lu-lab/mi-pi/docs/assembly images/IMG_20190503_181630.jpg

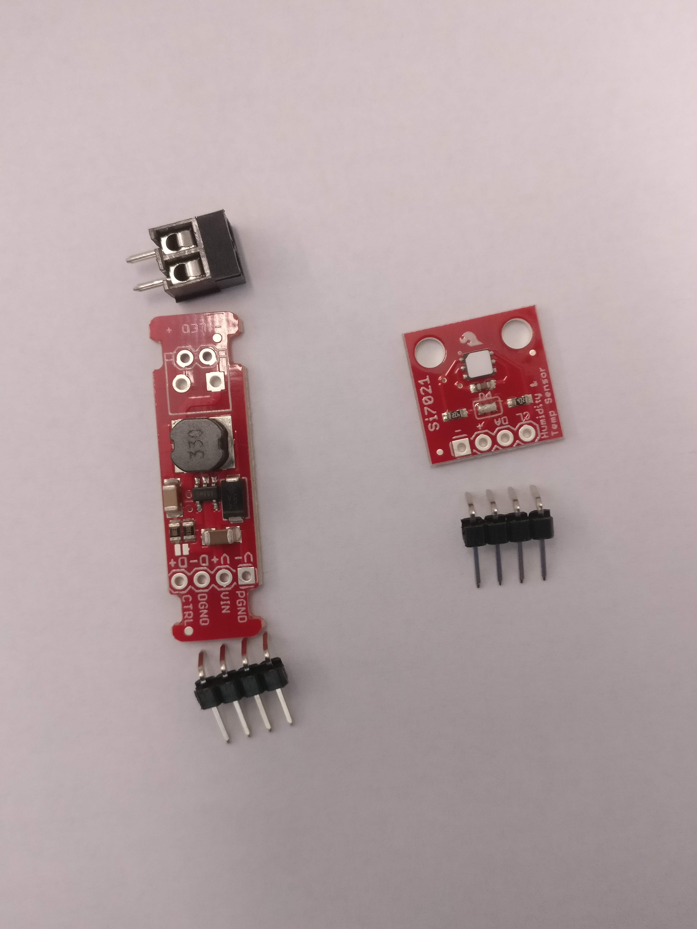
docs/assembly images/IMG_20190503_181630.jpg
