lu-lab/mi-pi/docs/assembly images/IMG_20190503_181736.jpg

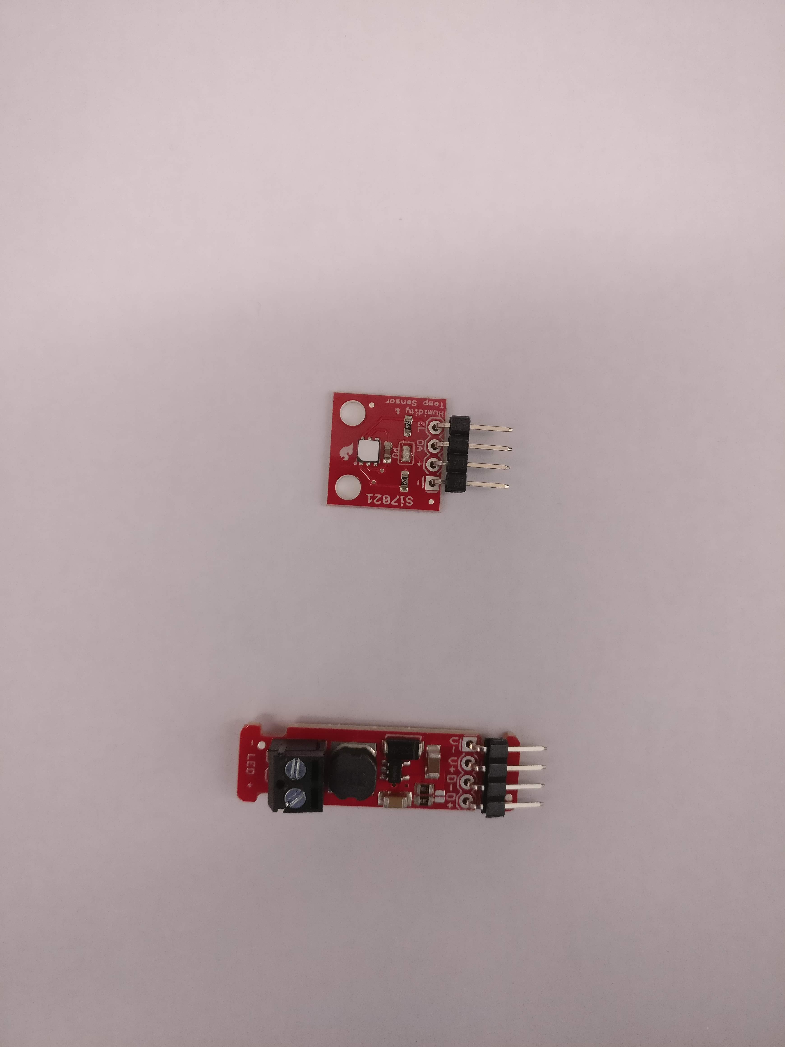
docs/assembly images/IMG_20190503_181736.jpg
