lu-lab/mi-pi/docs/assembly images/IMG_20190503_182429.jpg

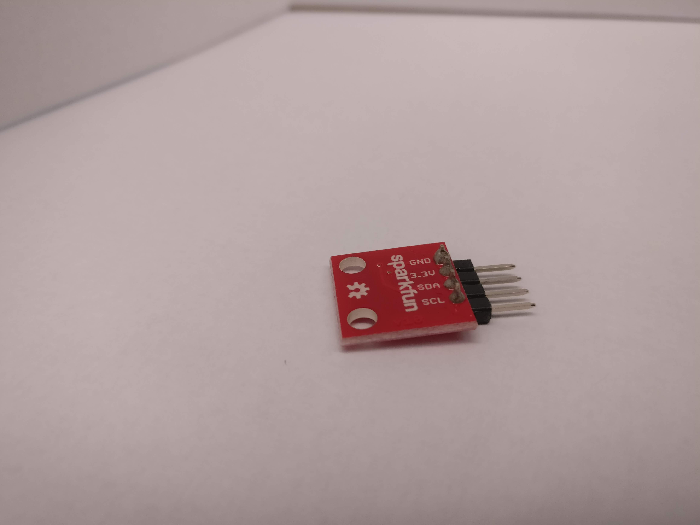
docs/assembly images/IMG_20190503_182429.jpg
