lu-lab/mi-pi/docs/assembly images/IMG_20190503_182439.jpg

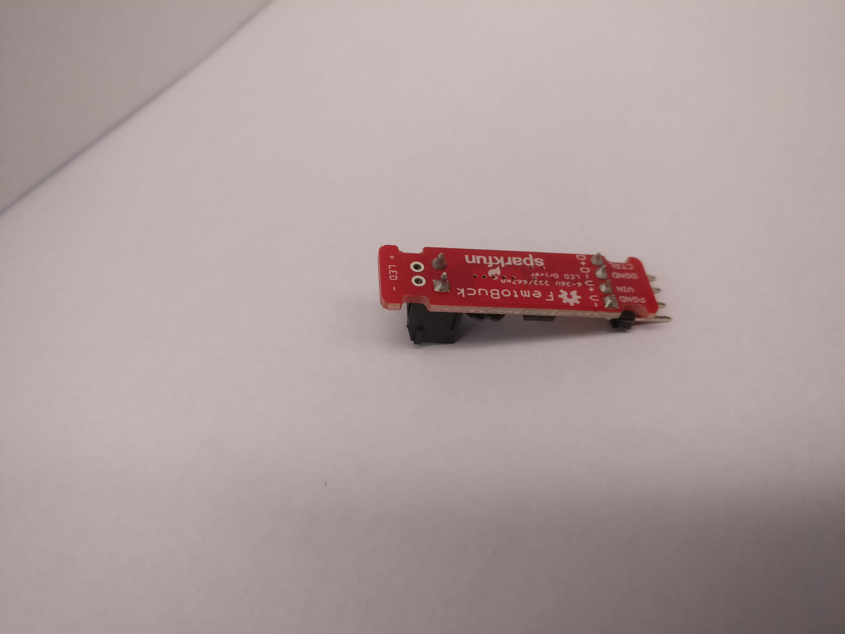
docs/assembly images/IMG_20190503_182439.jpg
