lu-lab/mi-pi/docs/assembly images/IMG_20190503_182455.jpg

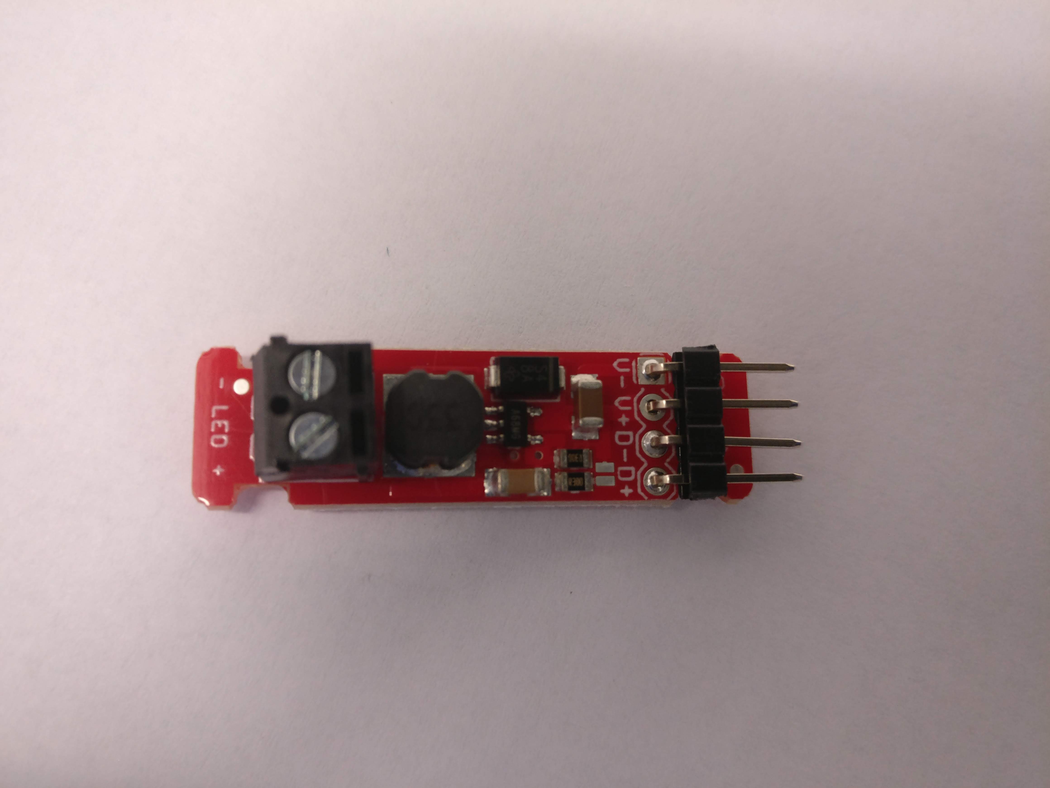
docs/assembly images/IMG_20190503_182455.jpg
