lu-lab/mi-pi/docs/assembly images/IMG_20190504_130719.jpg

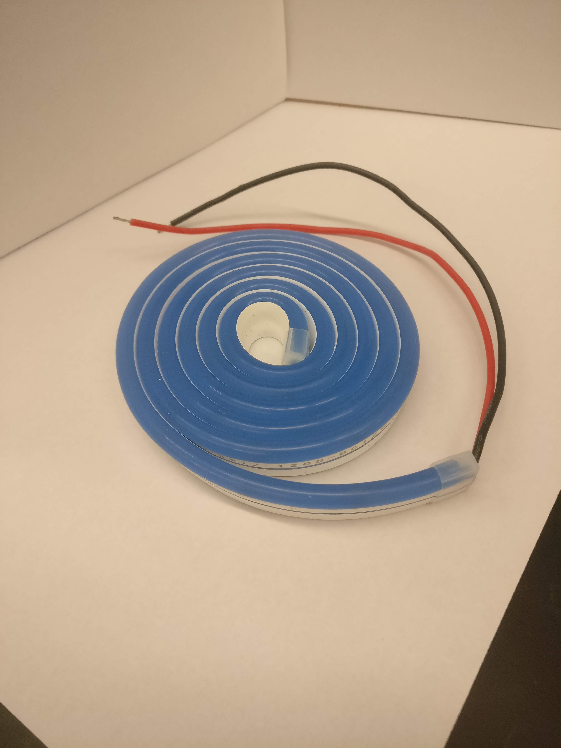
docs/assembly images/IMG_20190504_130719.jpg
