lu-lab/mi-pi/docs/assembly images/IMG_20190504_130858.jpg

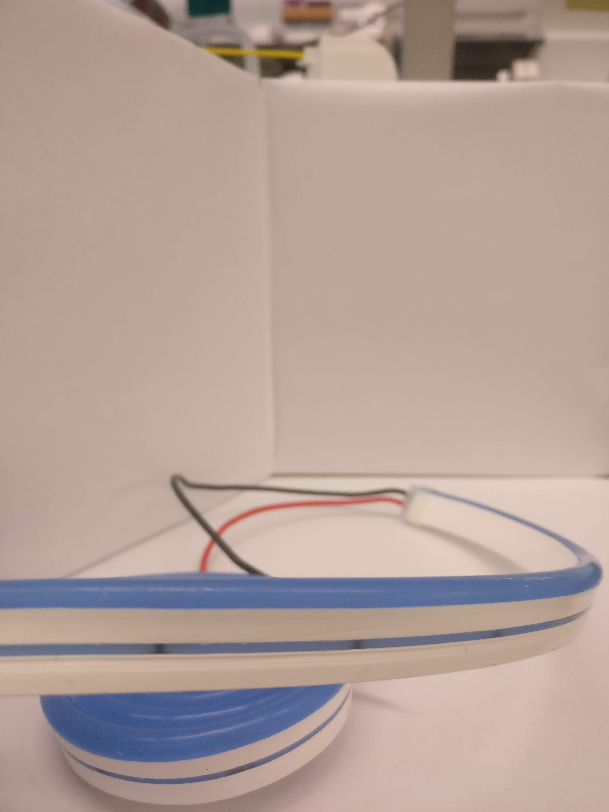
docs/assembly images/IMG_20190504_130858.jpg
