lu-lab/mi-pi/docs/assembly images/IMG_20190504_141730.jpg

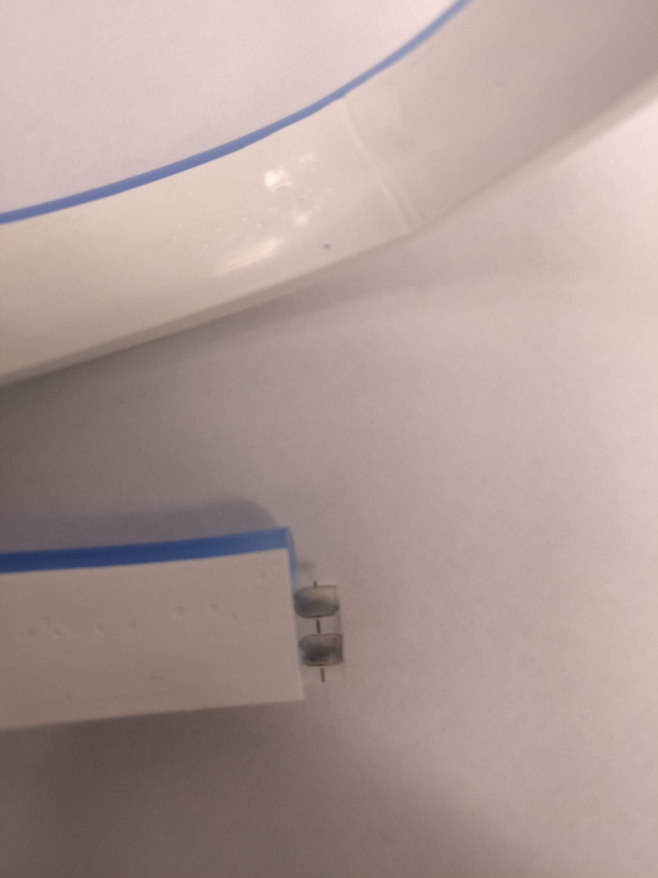
docs/assembly images/IMG_20190504_141730.jpg
