lu-lab/mi-pi/docs/assembly images/IMG_20190504_150758.jpg

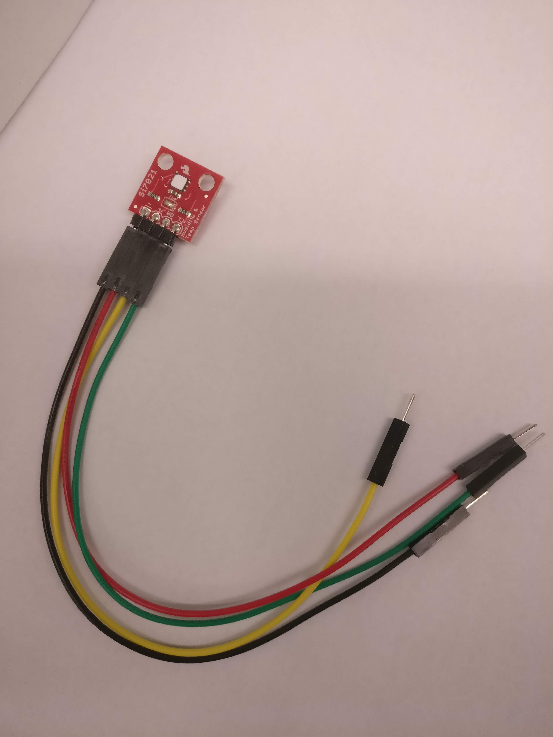
docs/assembly images/IMG_20190504_150758.jpg
