lu-lab/mi-pi/docs/assembly images/LED_strip_precut.jpg

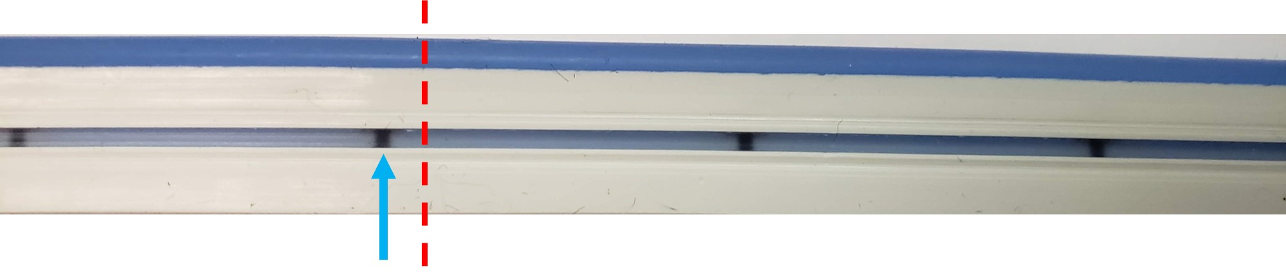
docs/assembly images/LED_strip_precut.jpg
