lu-lab/mi-pi/docs/assembly images/LED_strip_thirds.png

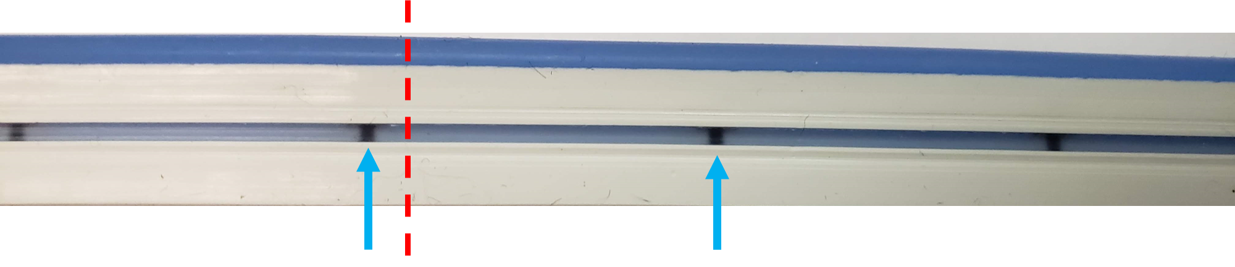
docs/assembly images/LED_strip_thirds.png
