lu-lab/mi-pi/docs/assembly images/temp_humidity.png

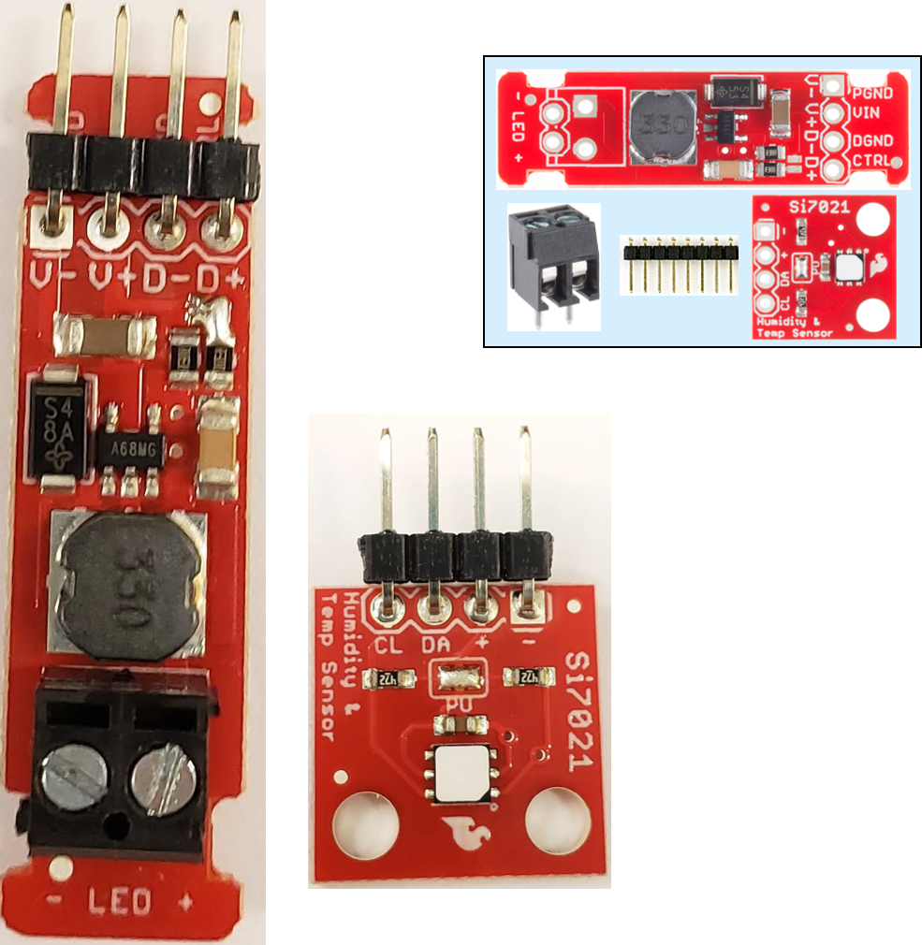
docs/assembly images/temp_humidity.png
