lu-lab/mi-pi/kivycam.ini

[worm info]
wormsex = H
strain = N2
genotype = N2
wormstage = adult
wormcomment = lay-off synchronization

[experiment settings]
google_spreadsheet_id = xxxxxxxxxxxxxxxxxxx
experimentlength = 6
physical = microfluidic
local_exp_path = /home/pi
remote_exp_path = /Apps/wormscope_uploads/
systemid = test
rclone_remote_name = dropbox

[LED matrix]
use_teensy = 0
matrixradius = 14
ledcolor = 255, 0, 0
do_linescan = 0
hc_image_frequency = 10

[camera settings]
resolution = 1920x1080
fps = 20
gain = 1.0

[webstreaming]
do_webstream = 0
youtube_link = rtmp://a.rtmp.youtube.com/live2/
youtube_key = xxxxxxxxxxxxxxxx

[pressure control]
pressurepath = /home/pi/piInterface/kivycam

[main image processing]
image_processing_mode = None
image_resolution = 640x480
save_images = 0
image_frequency = 15
is_driving_system = 1
paired_systemid: test2

[image delta]
delta_threshold = 15
num_pixel_threshold = 0

[image thresholding]
thresh_block_size = 61
keep_border_data = 0
image_threshold = 5
min_area = 50
max_area = 500
dilation_size = 3
xmin = 0
xmax = 640
ymin = 0
ymax = 480
