lu-lab/mi-pi/(commit log)

2019-08-30 fix bugs in experiment end
    [Updater.py, experiment.py, main.py, pivy_camera.py]
2019-08-30 add camera interrupt
2019-09-05 additional camera thread logging
2019-09-10 clear spreadsheet at exp start, processing thread bug fix
    [experiment.py, pivy_camera.py]
2019-09-12 reduce led exposure using C. elegans sleep characteristics
2019-09-13 camera bug
2019-10-10 input led illumination time per cycle
2019-10-10 use led_on_time to adjust total led dosage calculations
2019-10-21 add CNN image processing, switch camera to another process, remove vestiges of image thresholding
2019-10-22 close camera and reopen in run() method
2019-10-22 return CameraSupport to a thread object
2019-10-27 handle occasional google sheets name resolution error
    [pivy_camera.py]
2019-11-01 make sure OOM errors don't kill image processors
    [Updater.py, pivy_camera.py]
2019-11-07 launch each update as a new thread
2019-11-08 reduce number of threads launched by updater
2019-11-08 save frame bboxes instead of full image, add h5py
2019-11-13 ignore and log OSErrors in Repeating Timer and file upload
2020-01-31 - add teensy sketch - update hardware setup
2020-03-27 -documentation update
    [bill_of_materials.csv]
2020-10-22 Experiment.py updated to not do LED or humidity sensing without teensy
2020-10-22 updated pivy_camera.py to not turn on LEDs when there is no teensy
2020-10-22 Updated hardwareSupport.py for not using teensy if not found. Still need to add GPIO for temp sensing
2020-10-22 updated main.py for use_teensy in LED matrix
2020-10-22 added use_teensy to settings.py in LED matrix section
2020-10-23 trying to make sure led matrix is not getting commands if no teensy
2020-10-23 added debug messages for send_command to see where LED matrix is being incorrectly called
2020-10-23 added teensy_port = None in hardwareSupport
2020-10-27 Added GPIO temperature and humidity sensor reading to hardwareSupport
2020-10-27 Changed hardwareSupport get_temperature_humidity to return info like the serial function with teensy does
2020-10-27 Changed updater to use the GPIO function if no teensy
2020-10-27 fixed detect i2c address
    [hardwareSupport.py]
2020-10-27 changed TeensyConfig to not search for variable in locals
2020-10-28 debugging temp sensor
2020-10-28 more debugging temp sensor
2020-10-28 I think I fixed temp sense
    [hardwareSupport.py]
2020-10-28 debugging stop_experiment use teensy
2020-10-29 trying to fix shut down exp
    [main.py]
2020-10-29 added ledMatrix = none if no teensy
2020-11-03 debugging memory usage problems
    [Updater.py, pivy_camera.py]
2020-11-04 - video only and webstream modes directly saves to file - switch to filename generator
